uynitsuj/lerobot_teleoperator_yamactiveleader/BOM.md

# Bill of Materials

|Item|Qty|Cost|Link|
|---|---|---|---|
|Feetech Servos STS3215 1/147 Gear Ratio | 7 | $21.99 | https://www.seeedstudio.com/Feetech-ST-3215-C046-Standard-Torque-Servo-7-4V-1-147-Gear-Reduction-p-6461.html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 |
|UART Serial Bus Servo Driver Board | 1 | $10.55 or $19.19 for 2x bulk price | https://www.amazon.com/dp/B0D1R4SGFS?ref=ppx_yo2ov_dt_b_fed_asin_title&th=1 |
|5V 15A AC DC Power Adapter | 1 | $24.99 | https://www.amazon.com/dp/B01LXN7MN3?ref=ppx_yo2ov_dt_b_fed_asin_title&th=1 |
| 50pcs M2.3 x 8mm Stainless Steel Cross Pan Head Self Tapping Screws Bolts | 1 | $6.69 | https://www.amazon.com/dp/B01LXFTOAU?ref=ppx_yo2ov_dt_b_fed_asin_title |
| 120pcs M3 x 6mm | 1 | $7.49 | https://www.amazon.com/dp/B0DJQH3WSX?ref=ppx_yo2ov_dt_b_fed_asin_title&th=1 |
|---|---|---|---|
|||$203.65||
