uynitsuj/lerobot_teleoperator_yamactiveleader/stl_files/P8.stl

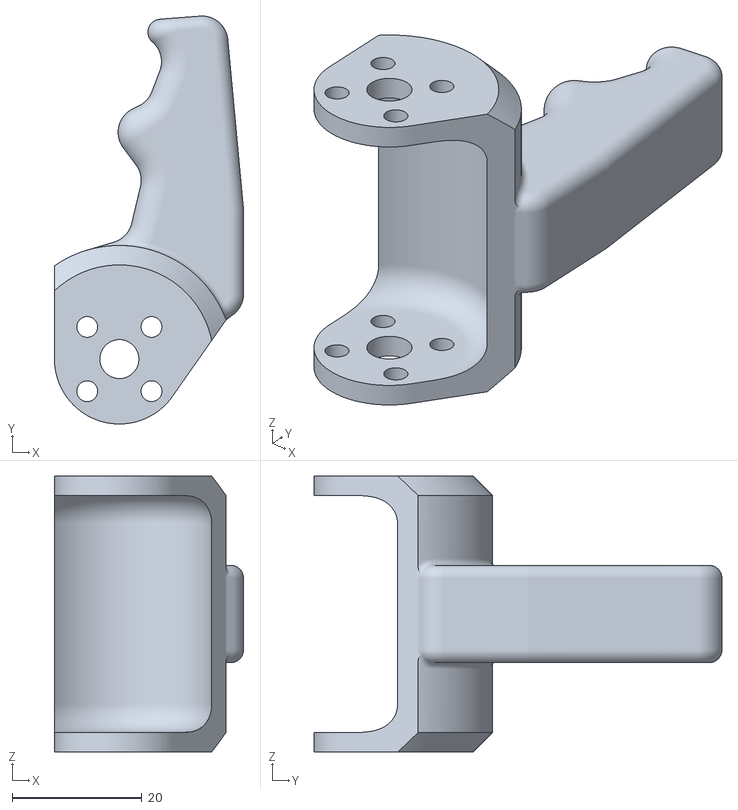
[picture p1: CAD file, 2026-03-02]
stl_files/P8.stl
29.1 x 62.8 x 42.5
