uynitsuj/lerobot_teleoperator_yamactiveleader/stl_files/P4.stl

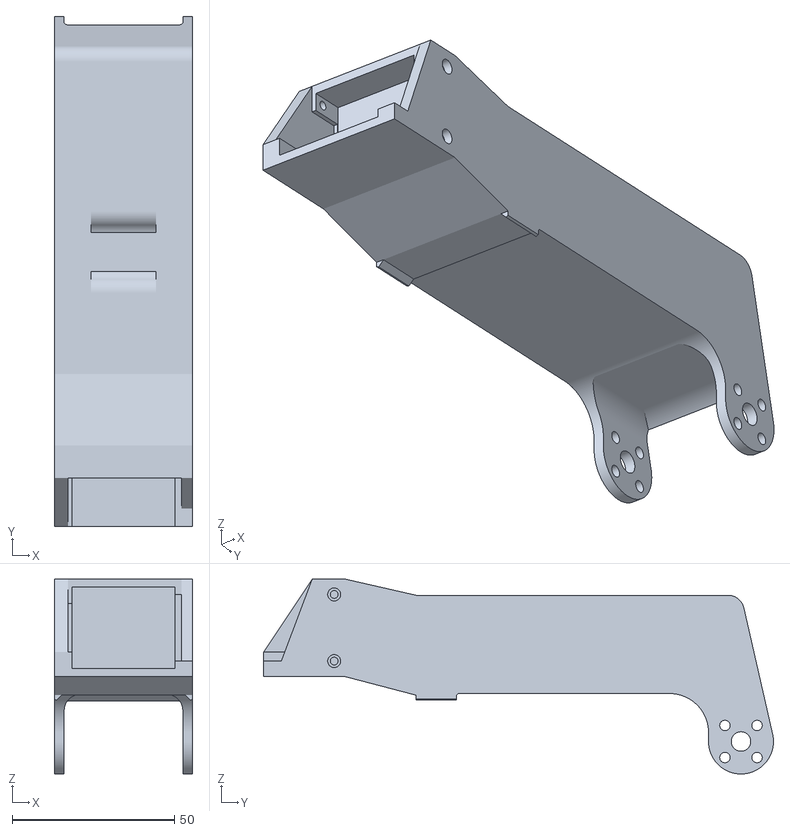
[picture p2: CAD file, 2026-03-02]
stl_files/P4.stl
42.5 x 156.9 x 60.0
