uynitsuj/lerobot_teleoperator_yamactiveleader/stl_files/P3.stl

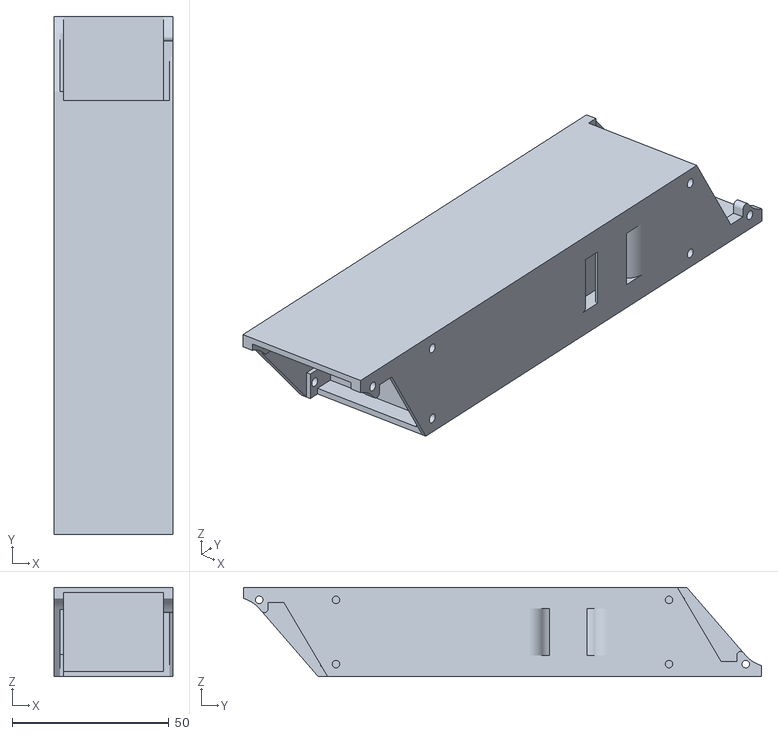
[picture p3: CAD file, 2026-03-02]
stl_files/P3.stl
37.8 x 165.2 x 28.5
