uynitsuj/lerobot_teleoperator_yamactiveleader/stl_files/P2.stl

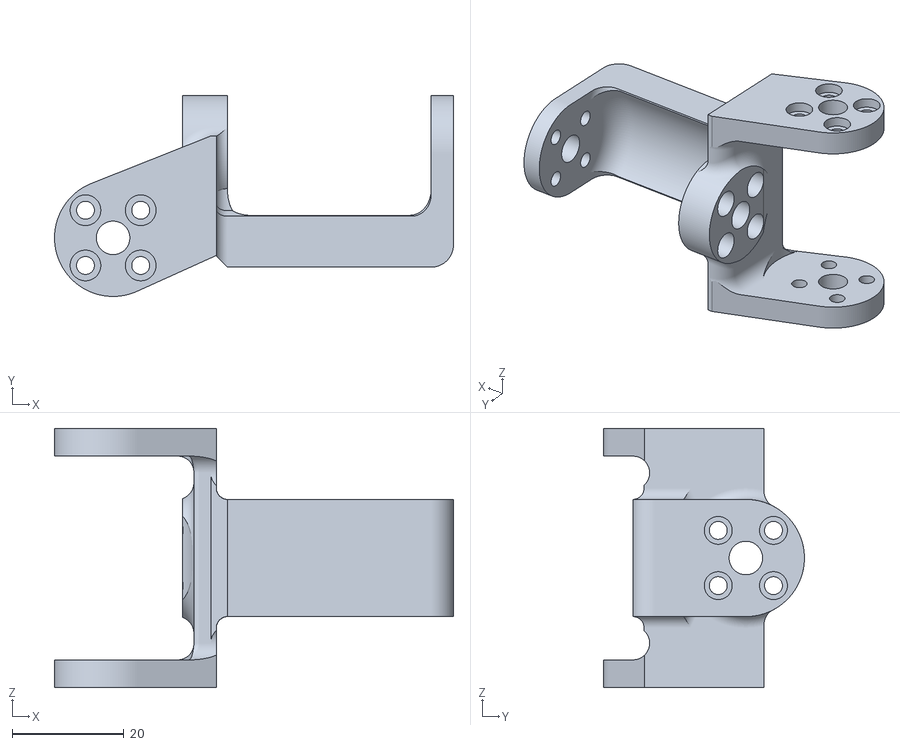
[picture p4: CAD file, 2026-03-02]
stl_files/P2.stl
71.5 x 36.0 x 46.5
