uynitsuj/lerobot_teleoperator_yamactiveleader/stl_files/P6.stl

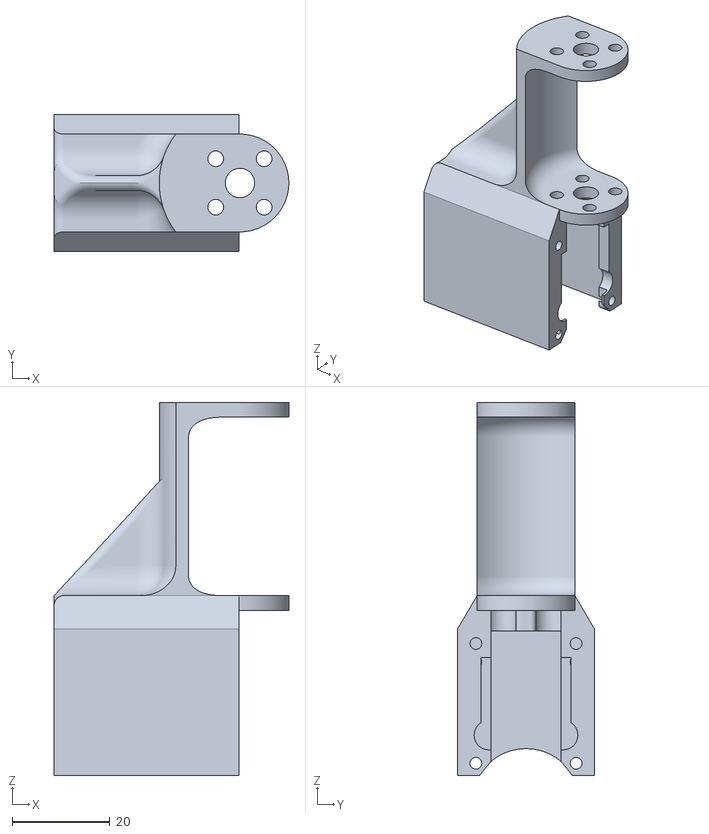
[picture p5: CAD file, 2026-03-02]
stl_files/P6.stl
48.0 x 28.0 x 76.3
