uynitsuj/lerobot_teleoperator_yamactiveleader/stl_files/P1.stl

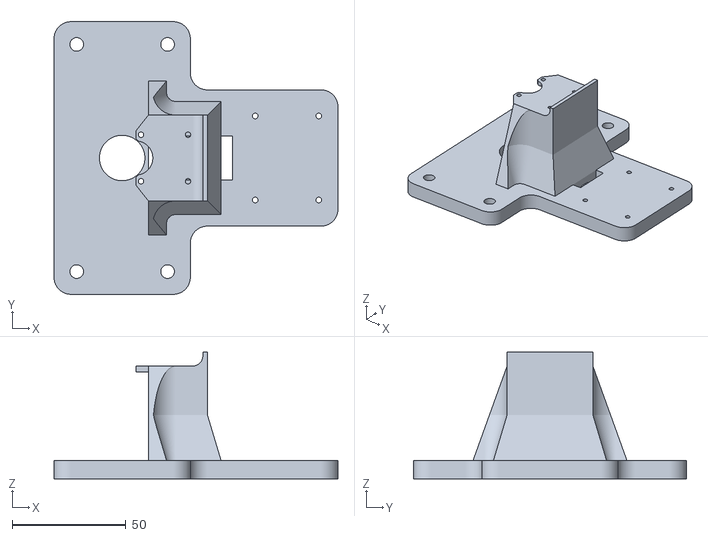
[picture p6: CAD file, 2026-03-02]
stl_files/P1.stl
125.0 x 120.0 x 55.7
