uynitsuj/lerobot_teleoperator_yamactiveleader/stl_files/P5.stl

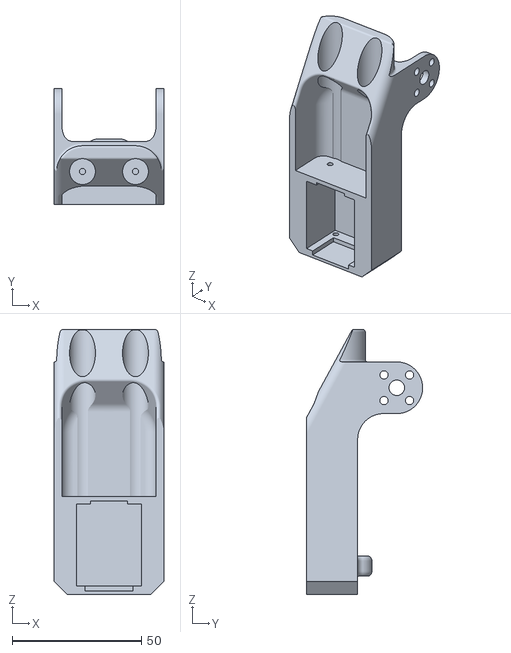
[picture p7: CAD file, 2026-03-02]
stl_files/P5.stl
42.5 x 45.0 x 102.5
