uynitsuj/lerobot_teleoperator_yamactiveleader/Assembly.md

# Assembly Instructions

|Item|Qty|Cost|Link|
|---|---|---|---|
|Feetech Servos STS3215 1/147 Gear Ratio | 5 | $24.99 | https://www.amazon.com/dp/B0FPGP6RXB?ref=ppx_yo2ov_dt_b_fed_asin_title&th=1 |
|Feetech Servos STS3215 1/345 Gear Ratio | 2 | $24.99 | https://www.amazon.com/dp/B0FKH518LC?ref=ppx_yo2ov_dt_b_fed_asin_title |
|UART Serial Bus Servo Driver Board | 1 | $10.55 or $19.19 for 2x bulk price | https://www.amazon.com/dp/B0D1R4SGFS?ref=ppx_yo2ov_dt_b_fed_asin_title&th=1 |
|5V 15A AC DC Power Adapter | 1 | $24.99 | https://www.amazon.com/dp/B01LXN7MN3?ref=ppx_yo2ov_dt_b_fed_asin_title&th=1 |
|Self-Tapping Screws M1.7-M3 | 1 | $9.59 | https://www.amazon.com/dp/B07ZH9GJWP?ref=ppx_yo2ov_dt_b_fed_asin_title |
| M3 Screws Assorted | 1 | $9.99 | https://www.amazon.com/dp/B0FGV5FCBN?ref=ppx_yo2ov_dt_b_fed_asin_title&th=1| 
|---|---|---|---|
|||$230.05||
