uynitsuj/lerobot_teleoperator_yamactiveleader/(commit log)

2026-03-02 add stls
    [P1.stl, P2.stl, P3.stl, P4.stl, P5.stl, P6.stl, P8.stl]
2026-03-05 add bom
2026-03-05 updated bom cost
2026-03-07 update trigger spring behavior, user no longer needs to call update trigger in environment loop. The YamActiveLeaderTeleoperator class handles this now
    [yam_active_leader.py]
2026-03-07 update intervention current delta threshold
2026-03-07 update bom
2026-03-07 update bom total cost
2026-03-10 add eeprom debug read and prints
2026-03-24 Revert "optimize freq by removing conditional dithering"
    This reverts commit 3d5da3d4dbf83dbf06267350e31a26a1f914a64e.
    [yam_active_leader.py]
2026-03-26 massively improve gripper spring behavior
2026-09-05 Modify quantity of Feetech Servos in BOM
    Updated the quantity of Feetech Servos STS3215 1/147 Gear Ratio from 5 to 7.
2026-09-05 Update BOM with new servo cost and link
    Updated the cost and link for Feetech Servos STS3215 in the BOM.
